rlnd-ldwg/pic-prog/hw/CP2102-UM2102_pinout.jpg

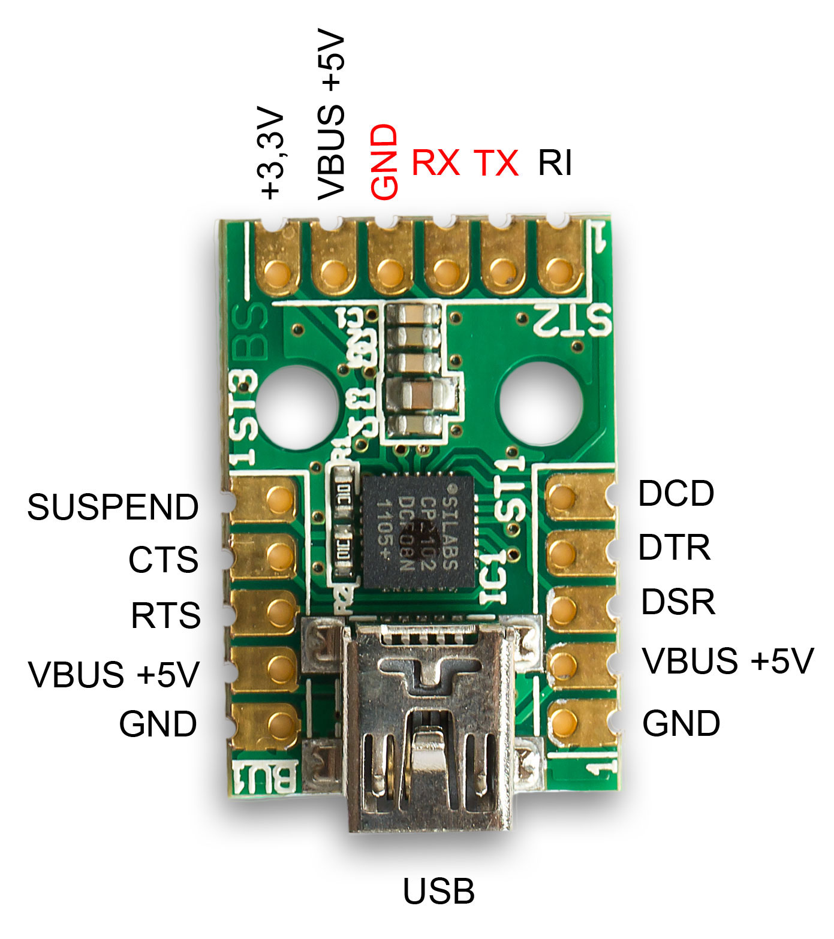
hw/CP2102-UM2102_pinout.jpg
