rlnd-ldwg/pic-prog/hw/PIC-Programmer-ICSP.png

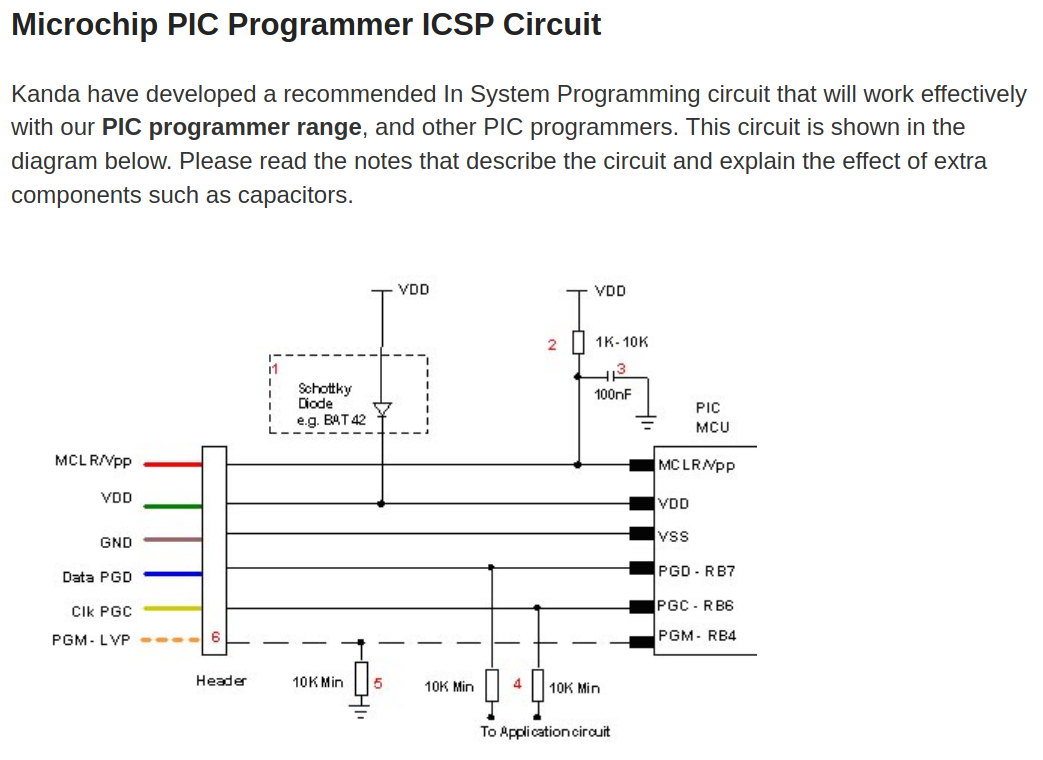
hw/PIC-Programmer-ICSP.png
