rlnd-ldwg/pic-prog/hw/PIC-Programmer_1.png

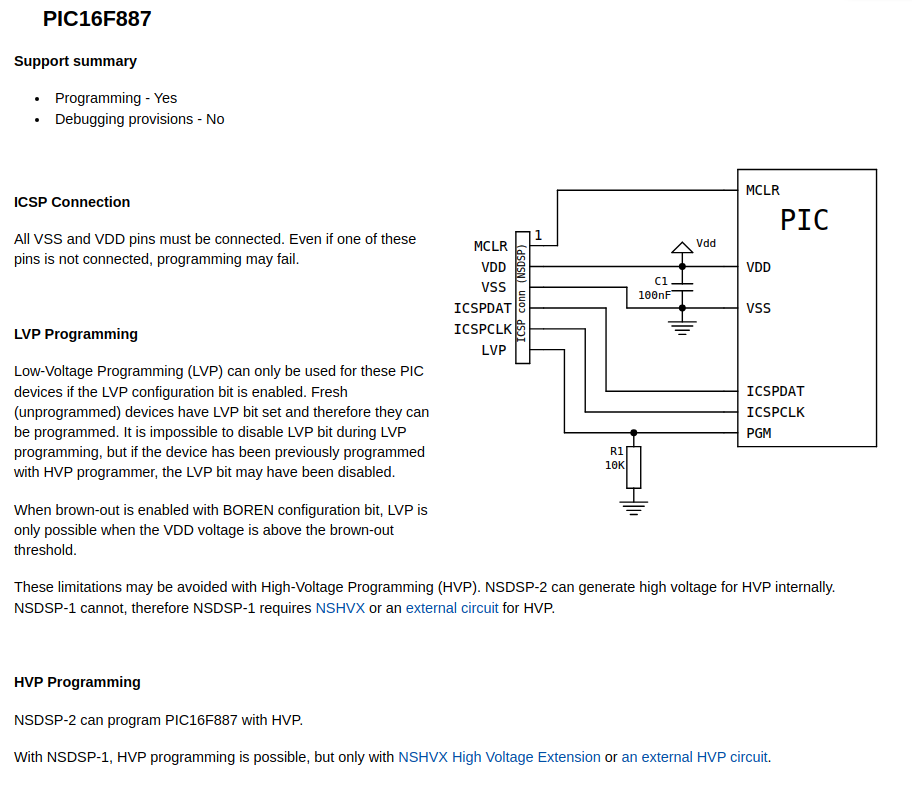
hw/PIC-Programmer_1.png
