rlnd-ldwg/pic-prog/hw/PIC-Programmer_2.png

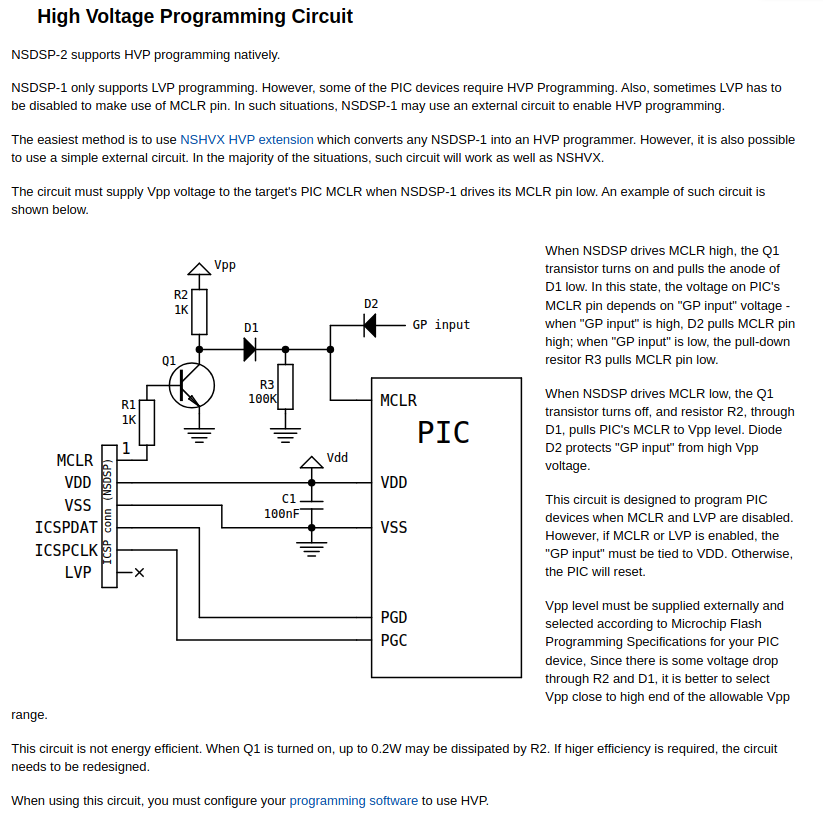
hw/PIC-Programmer_2.png
