rlnd-ldwg/pic-prog/hw/U-Verdoppler-NE555.gif

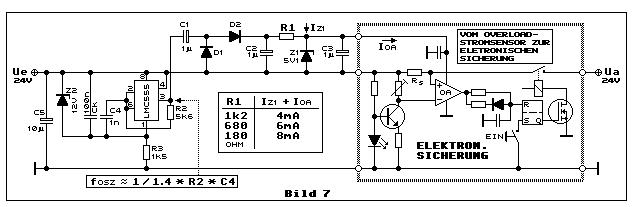
hw/U-Verdoppler-NE555.gif
