rlnd-ldwg/pic-prog/hw/USB-C_FT232.png

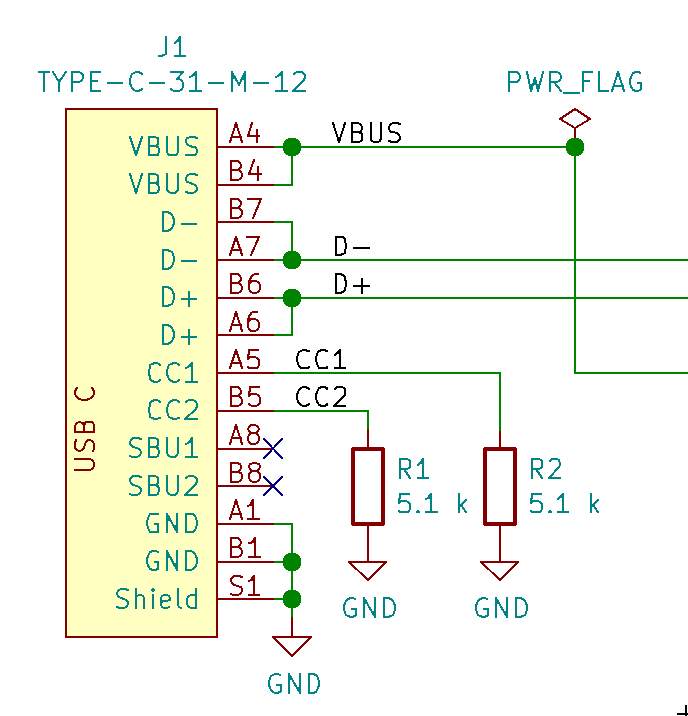
hw/USB-C_FT232.png
