rlnd-ldwg/pic-prog/hw/USB-FT232.png

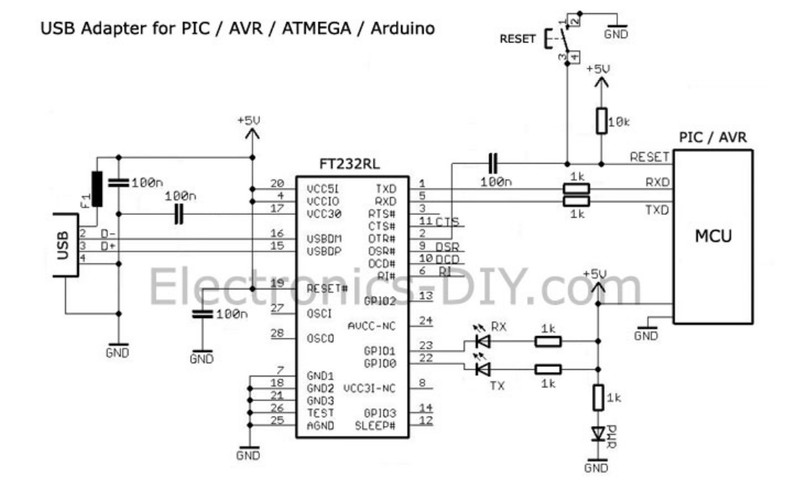
hw/USB-FT232.png
