rlnd-ldwg/pic-prog/hw/USB-Powered-FT232.png

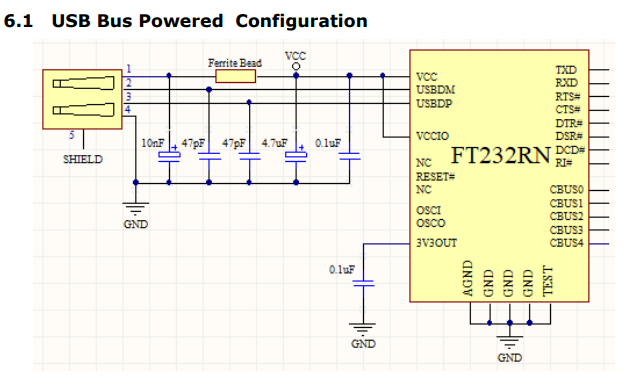
hw/USB-Powered-FT232.png
