rlnd-ldwg/pic-prog/ArdPicProg-Bauanleitung-rev02.pdf

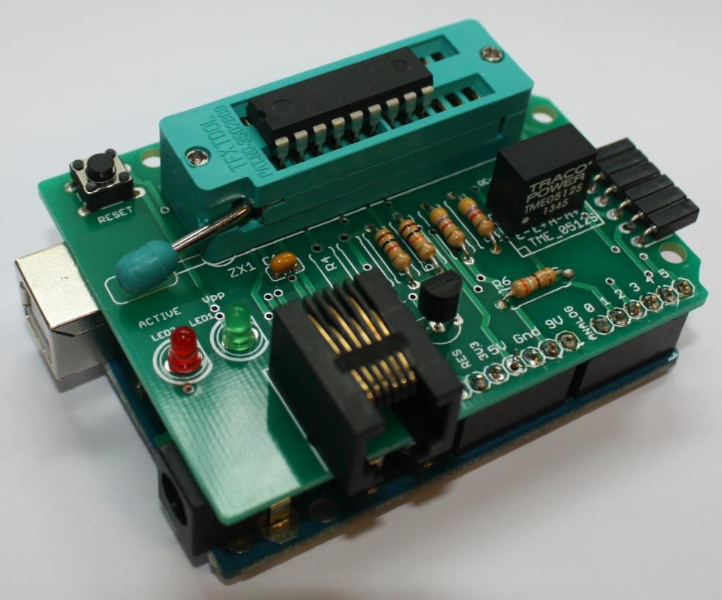
[picture p17: figure]

# ArdPicProg

# Arduino PIC Programmer

# Bauanleitung

Version 1.3
Stand 09/2018

Gregor Schlechtriem
webmaster@pikoder.de

www.pikoder.de

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

ii

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

iii

## Inhaltsverzeichnis

Allgemeine Hinweise | 5
Bausatzumfang und Hilfsmittel | 7
Aufbau | 9
Inbetriebnahme | 19
ArdPicProg Anschlussbelegung | 21
ArdPicProg Schaltung | 23

iv

5

1

# Allgemeine Hinweise

Bevor Sie mit dem Nachbau des ArdPicProg beginnen, empfiehlt es sich, dass Sie diese Bauanleitung erst einmal bis zum Ende durchlesen. Sie wissen dann, worauf es ankommt und vermeiden dadurch von vornherein Fehler, die manchmal nur noch mit viel Aufwand zu beheben sind.

Für den Nachbau des ArdPicProg werden Grundkenntnisse über elektronische Bauteile und ihre Behandlung, Löten sowie hinsichtlich des Arduino vorausgesetzt.

Führen Sie Lötungen und Verdrahtungen absolut sauber und gewissenhaft aus, verwenden Sie kein säurehaltiges Lötzinn, Lötfett o.ä. Vergewissern Sie sich, dass keine kalte Lötstelle vorhanden ist. Denn eine unsaubere Lötung oder schlechte Lötstelle, ein Wackelkontakt oder schlechter Aufbau bedeuten eine aufwändige und zeitraubende Fehlersuche und unter Umständen eine Zerstörung von Bauelementen.

Die Möglichkeit, dass nach dem Zusammenbau etwas nicht funktioniert, lässt sich durch einen gewissenhaften und sauberen Aufbau drastisch verringern. Kontrollieren Sie jeden Schritt, bevor Sie weiter gehen. Halten Sie sich an die Bauanleitung! Machen Sie den dort beschriebenen Schritt nicht anders und überspringen Sie nichts! Haken Sie jeden Schritt doppelt ab: einmal fürs Bauen, einmal fürs prüfen.

Nehmen Sie sich auf jeden Fall Zeit: Basteln ist keine Akkordarbeit und soll in erster Linie Spaß machen!

6

## Raum für eigene Notizen:

7

2

# Bausatzumfang und Hilfsmittel

Der vorliegende Bausatz enthält alle zum Aufbau eines ArdPicProg benötigten Komponenten. Bitte überprüfen Sie zunächst die Vollständigkeit anhand der folgenden Stückliste.

# Stückliste: ArdPicProgrammer

Anz. Widerstände* | Bezeichnung | √
1 | 10k, 0,25W | R1
1 | 1k, 0,25W | R2
2 | 4k7, 0,25W | R5,R7
1 | 390R, 0,25W | R6
*R3 und R4 werden nicht bestückt.

### Kondensatoren

1 | 100n | C1

### Halbleiter

1 | BC548C | Q1
1 | LED 3mm grün | LED1
1 | LED 3mm rot | LED2

### Sonstiges

2 | Pin Header 6 pol. | J3, ANALOG
2 | Pin Header 8 pol. | J1, POWER
1 | RJ-12 Buchse | J7
1 | Female Header 6 pol. gew. (2x3pol) | J8
1 | DC-DC-CONVERTER TME_0512S | TME_0512S

8

## Stückliste: ArdPicProgrammer (fortgesetzt)

Anz. | Bezeichnung | √
1 | RESET-Taster | RESET
1 | ZIF Programmiersockel 18-24pol. | ZX1
1 | Leiterplatte

Darüber hinaus werden für den Aufbau dieses Bausatzes folgende Hilfsmittel benötigt:

1. Elektroniklötkolben
2. Elektroniklötzinn
3. Seitenschneider zur Kürzung der Bauteilanschlüsse

Für die Inbetriebnahme dieses Bausatzes werden darüber hinaus noch benötigt:

1. Arduino mit Programmiersketch (Download aus dem Internet)
2. PC mit Anwendungssoftware (Download aus dem Internet)

9

3

# Aufbau

Um die Nachbausicherheit zu erhöhen, erfolgt der Aufbau in zwei Schritten:

1. Baustufe I: Montage der Bauelemente auf bzw. unter der Platine
2. Baustufe II: Inbetriebnahme und Funktionstest

Die folgenden Abschnitte beschreiben die Montage der Bauelemente auf der Platine. Zunächst werden die Bauteile auf der Platinenoberseite bestückt. Hierbei wird der Bestückungsvorgang selber durch den Bestückungsaufdruck der Leiterplatte unterstützt. Die Reihenfolge der Bestückung hängt von der Höhe der Bauteile ab – es gilt grundsätzlich, dass zunächst die flachsten Bauteile bestückt werden. Danach werden die Headerleisten, die die Verbindung zwischen dem Programmer und dem Arduino herstellen, von der Unterseite der Platine her eingesteckt und auf der Oberseite verlötet.

## Bestückung der Widerstände R1, R2 und R5 – R7

Zuerst werden die Widerstände R1, R2 und R5-R7 bestückt. Hierzu werden die Anschlussdrähte entsprechend dem Rastermaß rechtwinkelig abgebogen und in die vorgesehenen Bohrungen laut Bestückungsplan gesteckt. Bitte beachten Sie die Farbkodierung der Widerstände.

Damit die Bauteile beim Umdrehen der Platine nicht herausfallen können, biegen Sie die Anschlussdrähte ca 45° auseinander und verlöten diese dann sorgfältig mit den Leiterbahnen auf der Rückseite der Platine. Anschließend werden die überstehenden Drähte abgeschnitten.

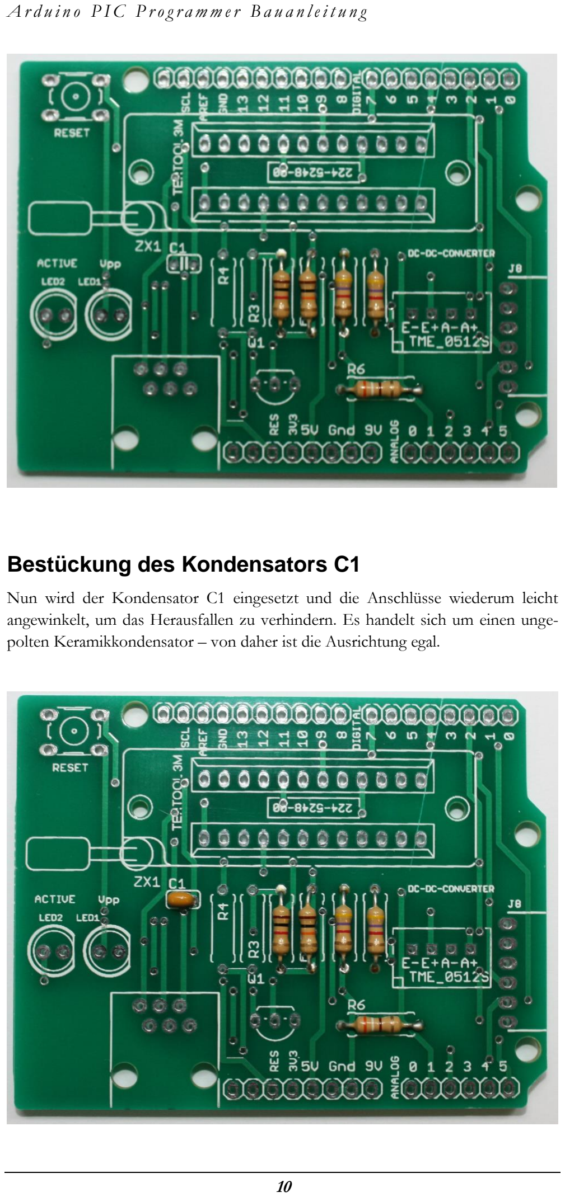
[picture p18: page 10]

10

## Bestückung des Kondensators C1

Nun wird der Kondensator C1 eingesetzt und die Anschlüsse wiederum leicht angewinkelt, um das Herausfallen zu verhindern. Es handelt sich um einen ungepolten Keramikkondensator – von daher ist die Ausrichtung egal.

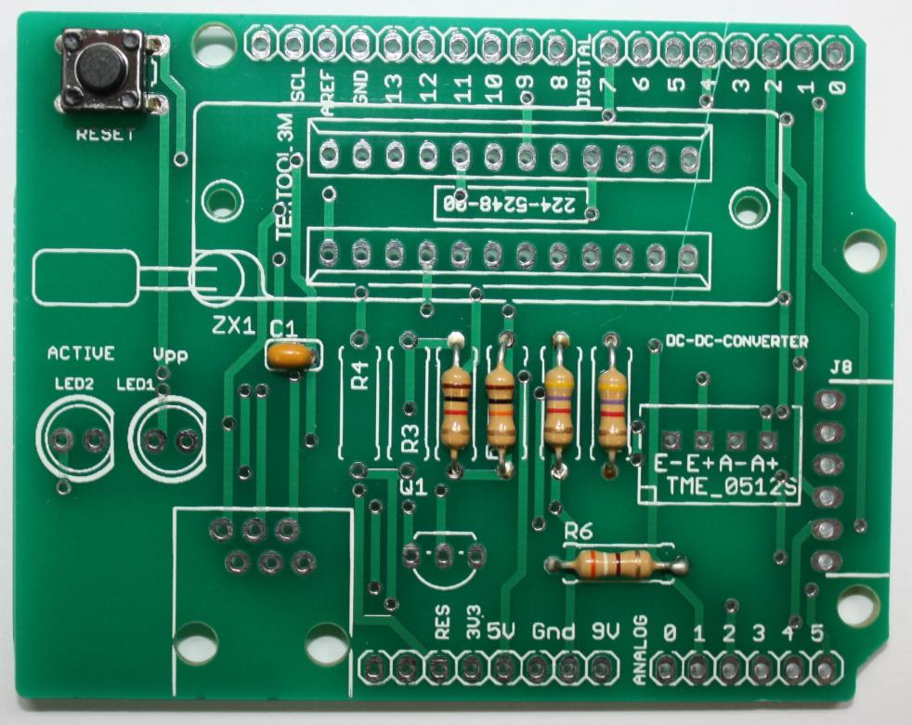
[picture p19: figure]

11

## Bestückung des Resettasters

Es folgt das Einsetzen und Verlöten des Resettasters. Die Lage der Bohrungen lässt nur eine Einbaurichtung zu – von daher ist die korrekte Ausrichtung gewährleistet.

## Bestückung der Leuchtdioden

Leuchtdioden sind gepolte Bauelemente, so dass bei der Bestückung die Einbaurichtung genau zu beachten ist. Die Gehäuse der Leuchtdioden sind an einer Seite abgeflacht – wie auch im Bestückungsaufdruck dargestellt und durch den roten Pfeil im folgenden Bild gekennzeichnet. Als zusätzliche Hilfe sind die Anschlussbeine unterschiedlich lang: der Pin an der abgeflachten Seite ist kürzer.

Stecken Sie die LEDs unter Beachtung der Polung in die entsprechende Position auf der Bestückungsseite der Leiterplatte. Die LEDs werden so eingelötet, dass das Gehäuse direkt auf der Platinenoberseite aufliegt.

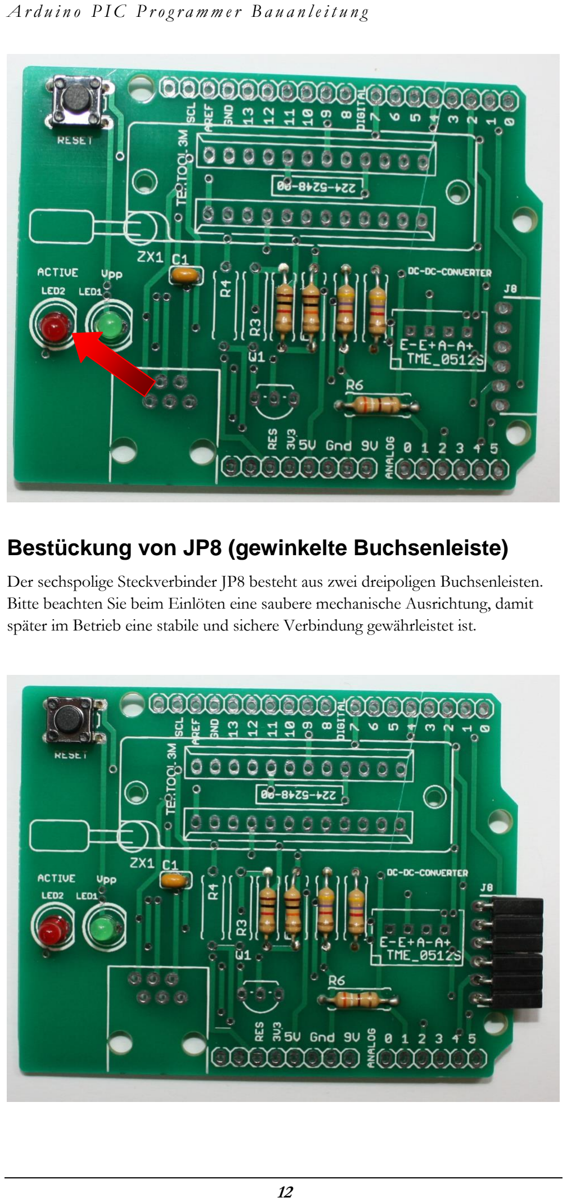
[picture p20: page 12]

12

## Bestückung von JP8 (gewinkelte Buchsenleiste)

Der sechspolige Steckverbinder JP8 besteht aus zwei dreipoligen Buchsenleisten. Bitte beachten Sie beim Einlöten eine saubere mechanische Ausrichtung, damit später im Betrieb eine stabile und sichere Verbindung gewährleistet ist.

## Bestückung des Transistors Q1

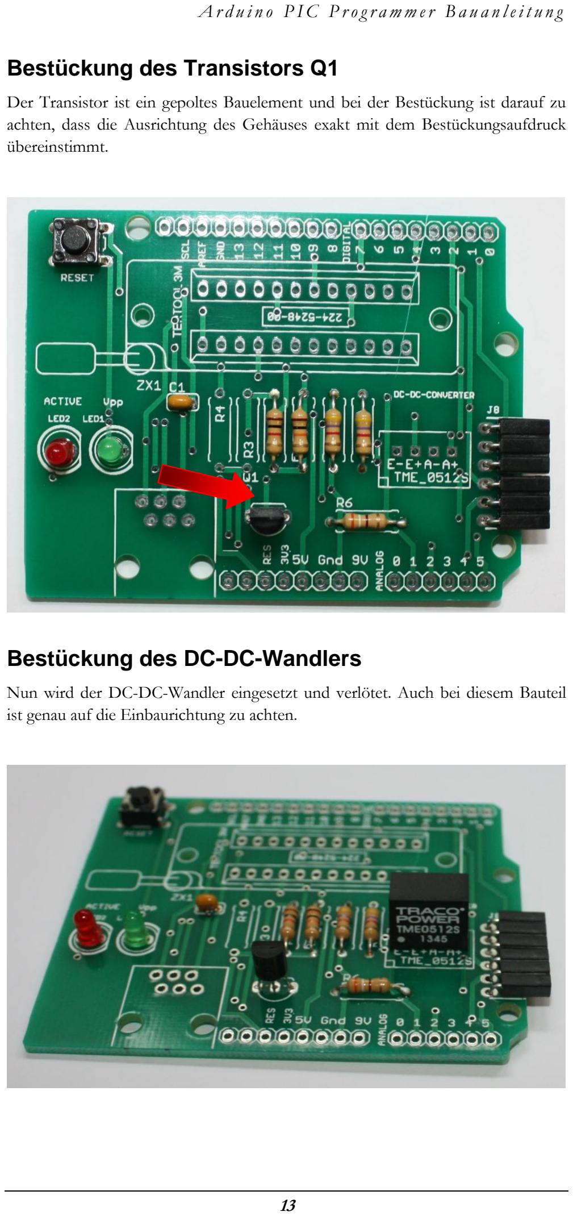
[picture p21: page 13]

13

Der Transistor ist ein gepoltes Bauelement und bei der Bestückung ist darauf zu achten, dass die Ausrichtung des Gehäuses exakt mit dem Bestückungsaufdruck übereinstimmt.

## Bestückung des DC-DC-Wandlers

Nun wird der DC-DC-Wandler eingesetzt und verlötet. Auch bei diesem Bauteil ist genau auf die Einbaurichtung zu achten.

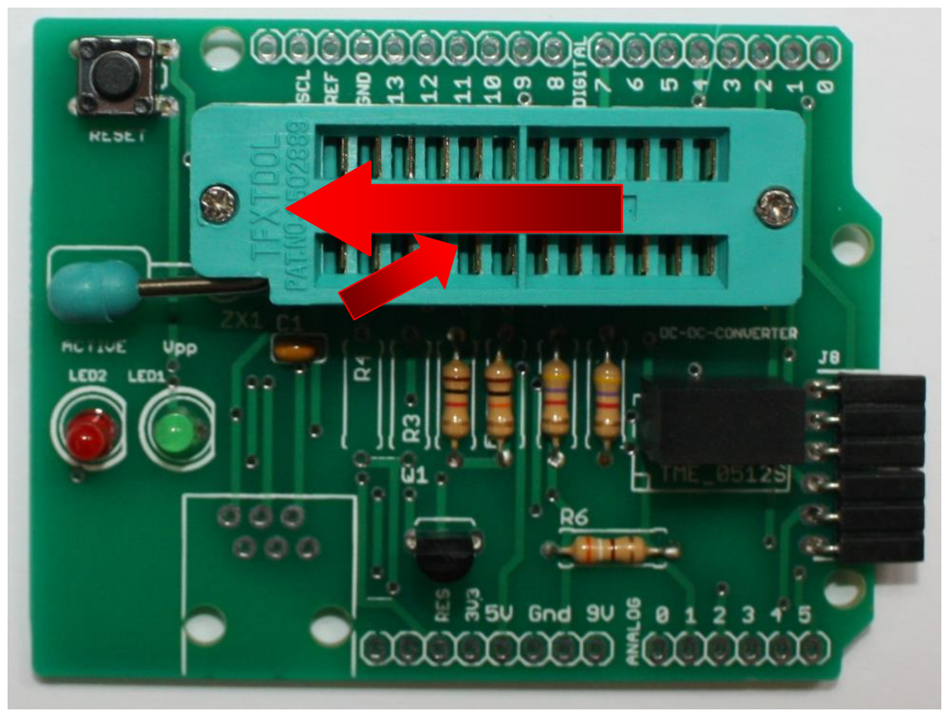
[picture p22: figure]

14

## Bestückung des Testsockels

Stecken Sie den Testsockel in die entsprechende Position auf der Bestückungsseite der Leiterplatte. Beachten Sie hierbei ebenfalls wieder die Einbaurichtung. Sollte Ihrem Bausatz ein Testsockel mit weniger als 24 Pin beiliegen, dann ist der Sockel in den vorhandenen Bohrungen linksbündig so zu positionieren, wie im nachfolgenden Bild dargestellt (die rechten Bohrungen bleiben unbenutzt)

Um zu verhindern, dass beim Herumdrehen der Platine zum Löten die Fassung wieder herausfällt, werden zwei schräg gegenüberliegende Pins der Fassung umgebogen und danach werden alle Anschlüsse verlötet.

## Bestückung der RJ12 Buchse

Als letztes Bauteil, das auf der Oberseite bestückt wird, folgt nun die RJ12 Einbaubuchse.

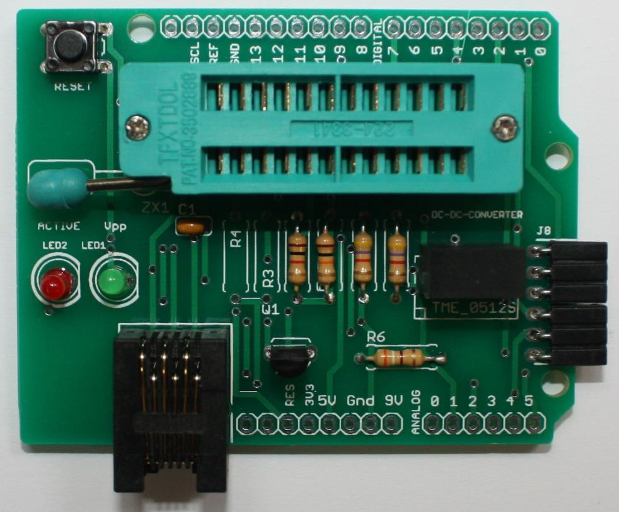
[picture p23: figure]

15

## Bestückung der Stiftleisten zur Verbindung mit dem Arduino

Nun werden die Stiftleisten bestückt. An der im Bild unteren Seite der Platine werden die beiden sechspoligen Leisten verlötet und oben die beiden achtpoligen Verbinder. Bitte brachten Sie die Position (an den Lötstellen im Bild erkennbar – die freien Bohrungen sind mit einem „X“ gekennzeichnet).

Um eine gute Ausrichtung zu erreichen, können die Steckverbinder auch in einen (spannungslosen) Arduino eingesteckt werden. Die Programmer-Leiterplatte wird dann aufgesetzt und die Steckverbinder werden dann verlötet. Der Arduino dient also als „mechanische Lehre“ und gewährleistet die korrekte Position und Ausrichtung der Pins. Hierbei ist allerdings auf zügiges Löten zu achten, um eine Beschädigung des Arduino auszuschließen.

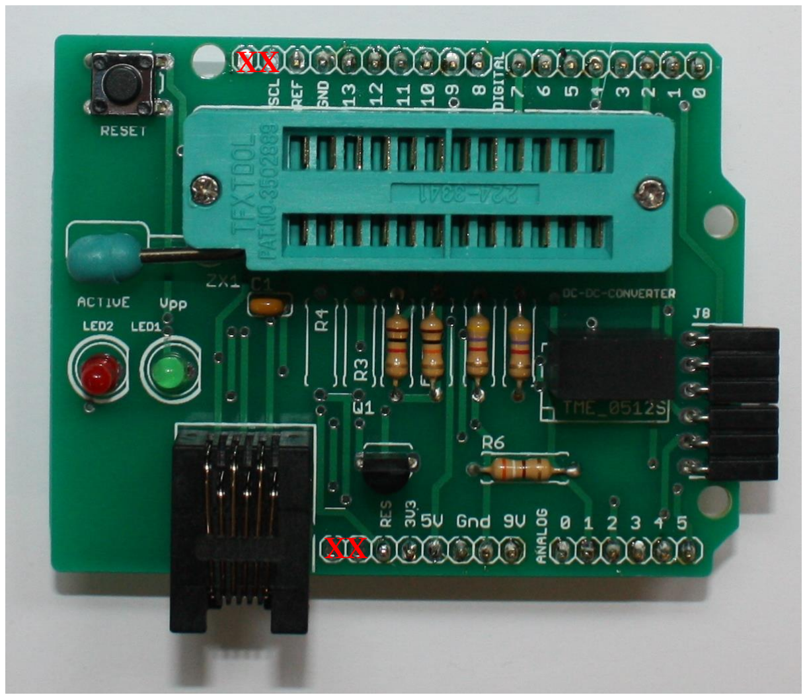
[picture p24: figure]

16

## Lötbrücke

Leider fehlt auf der Leiterplatte eine Verbindung, ohne die der Programmer nicht funktionsfähig ist.

Das nachfolgende Bild zeigt Ihnen, welche Punkte miteinander zu verbinden sind (mit rotem Pfeil gekennzeichnet). Die Verbindung selber kann, wie im grünen Rahmen dargestellt, relativ einfach durch einen „Lötklecks“ oder alternativ durch einen kurzen Draht hergestellt werden.

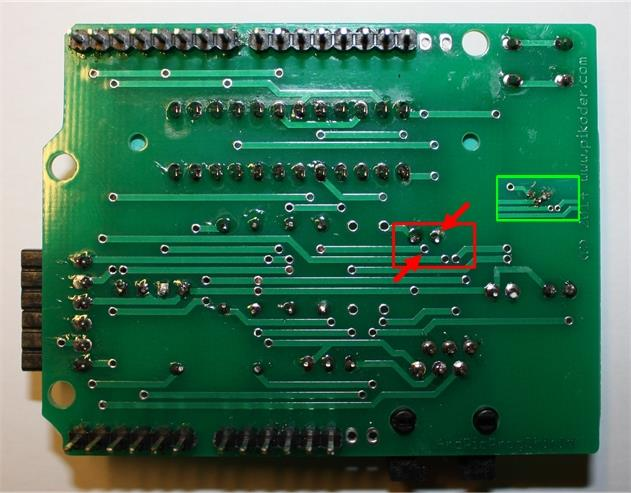
[picture p25: figure]

17

18

## Raum für eigene Notizen:

19

4

# Inbetriebnahme

Die Inbetriebnahme des Programmers ist im ArdPicProg User Guide beschrieben. Das Dokument kann auf http://www.pikoder.de/download/ArdPicProg User Guide.pdf (http://www.pikoder.de/download/ArdPicProg%20User%20Guide.pdf) herunter geladen werden.

20

## Raum für eigene Notizen:

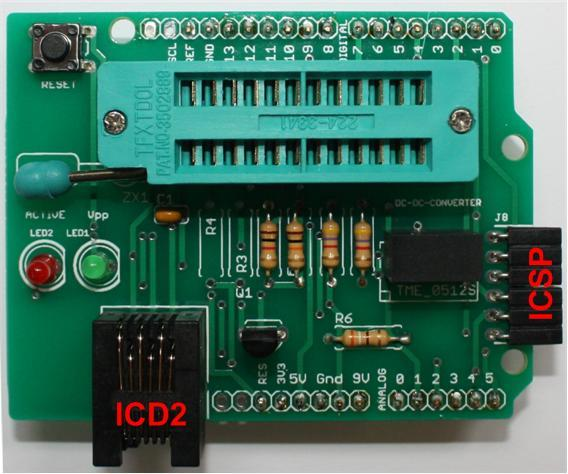
[picture p26: figure]

21

A

# ArdPicProg Anschlussbelegung

22

## Raum für eigene Notizen:

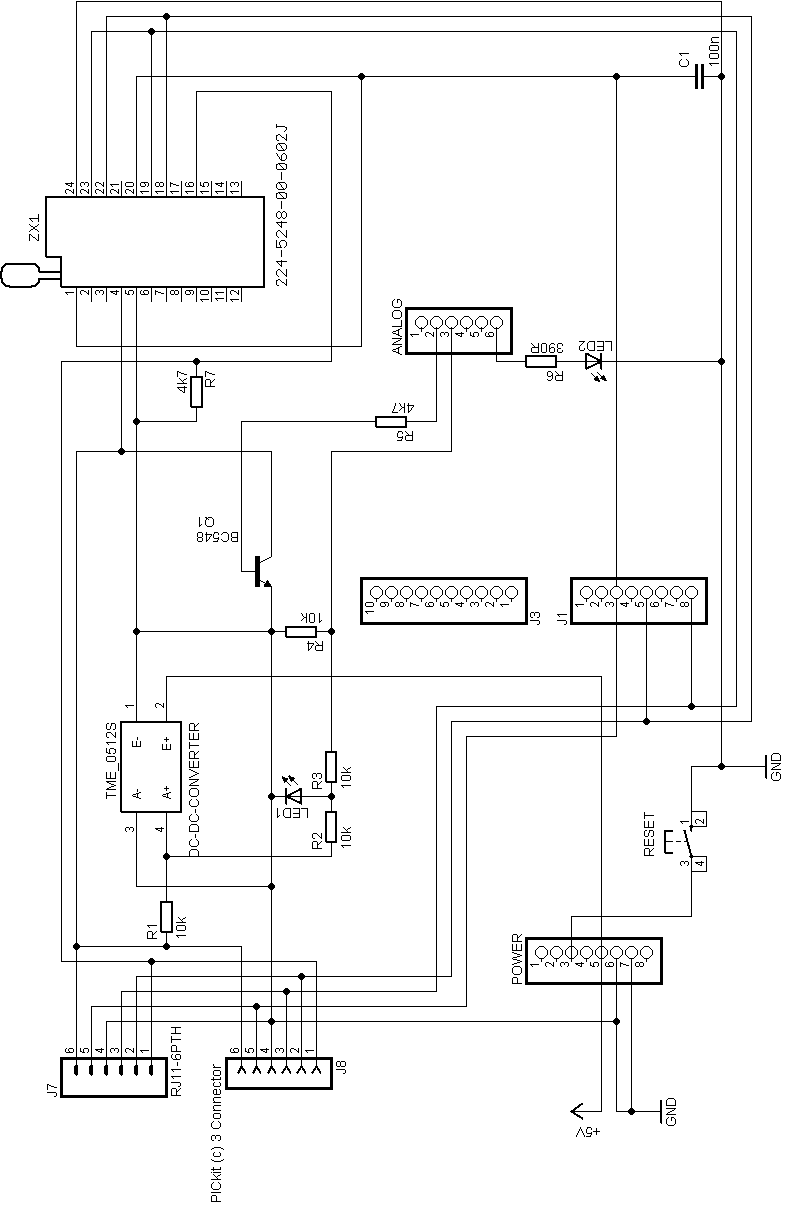
[picture p27: figure]

23

B

# ArdPicProg Schaltung
