rlnd-ldwg/pic-prog/hw/Prints.odt

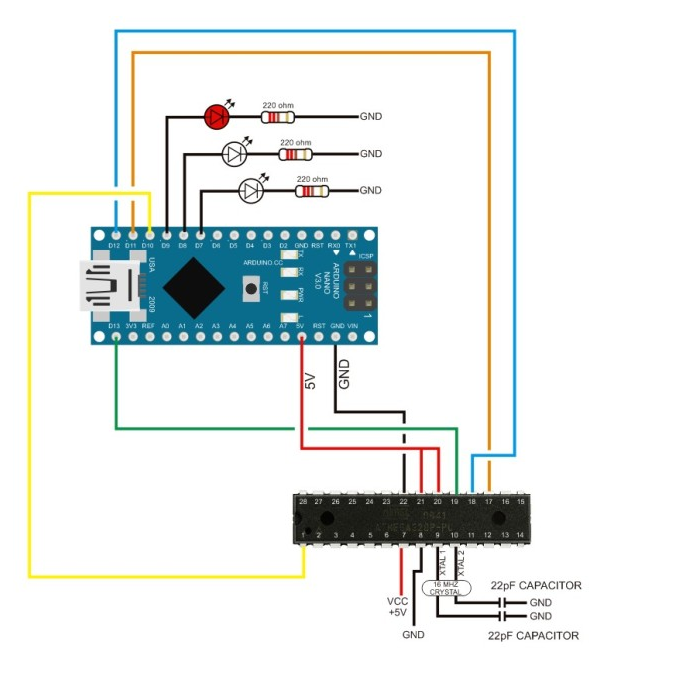
[picture p28: figure]
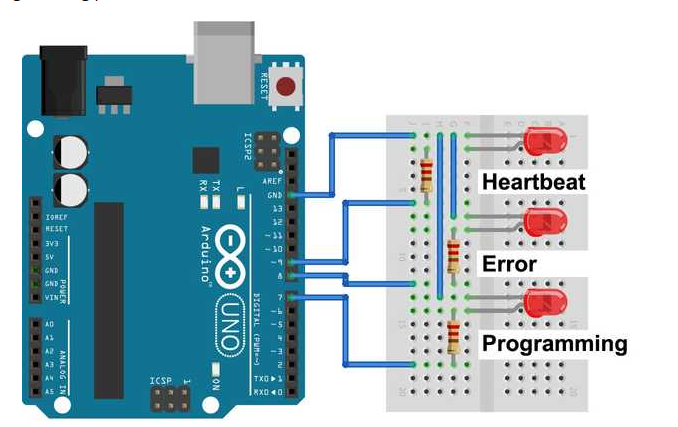
[picture p29: figure]
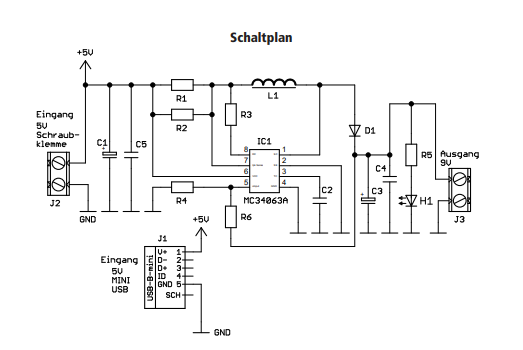
[picture p30: figure]

https://www.mikrocontroller.net/articles/MC34063

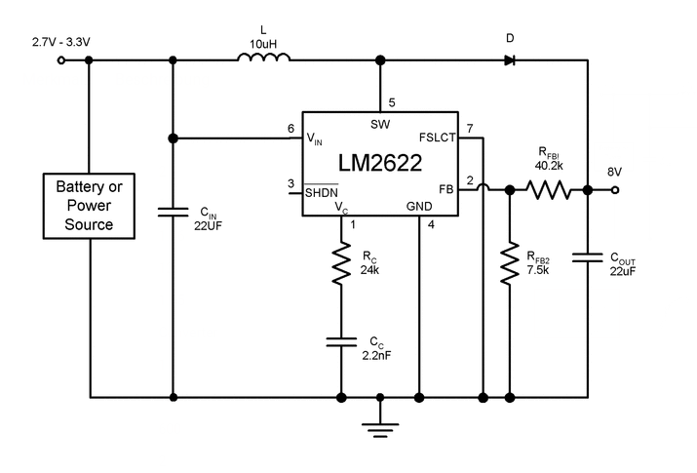
[picture p31: figure]

https://www.ti.com/product/de-de/LM2622

Original

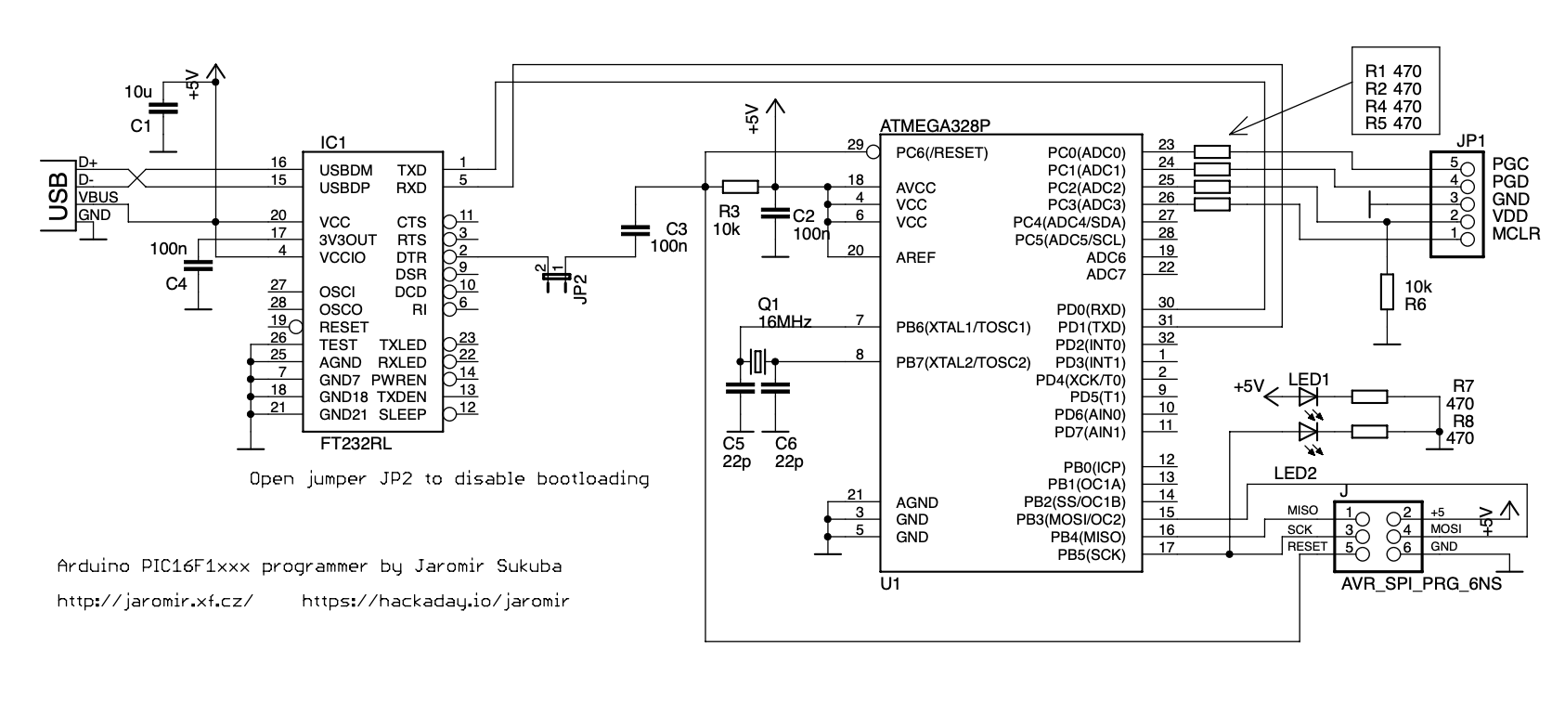
[picture p32: figure]

HVP

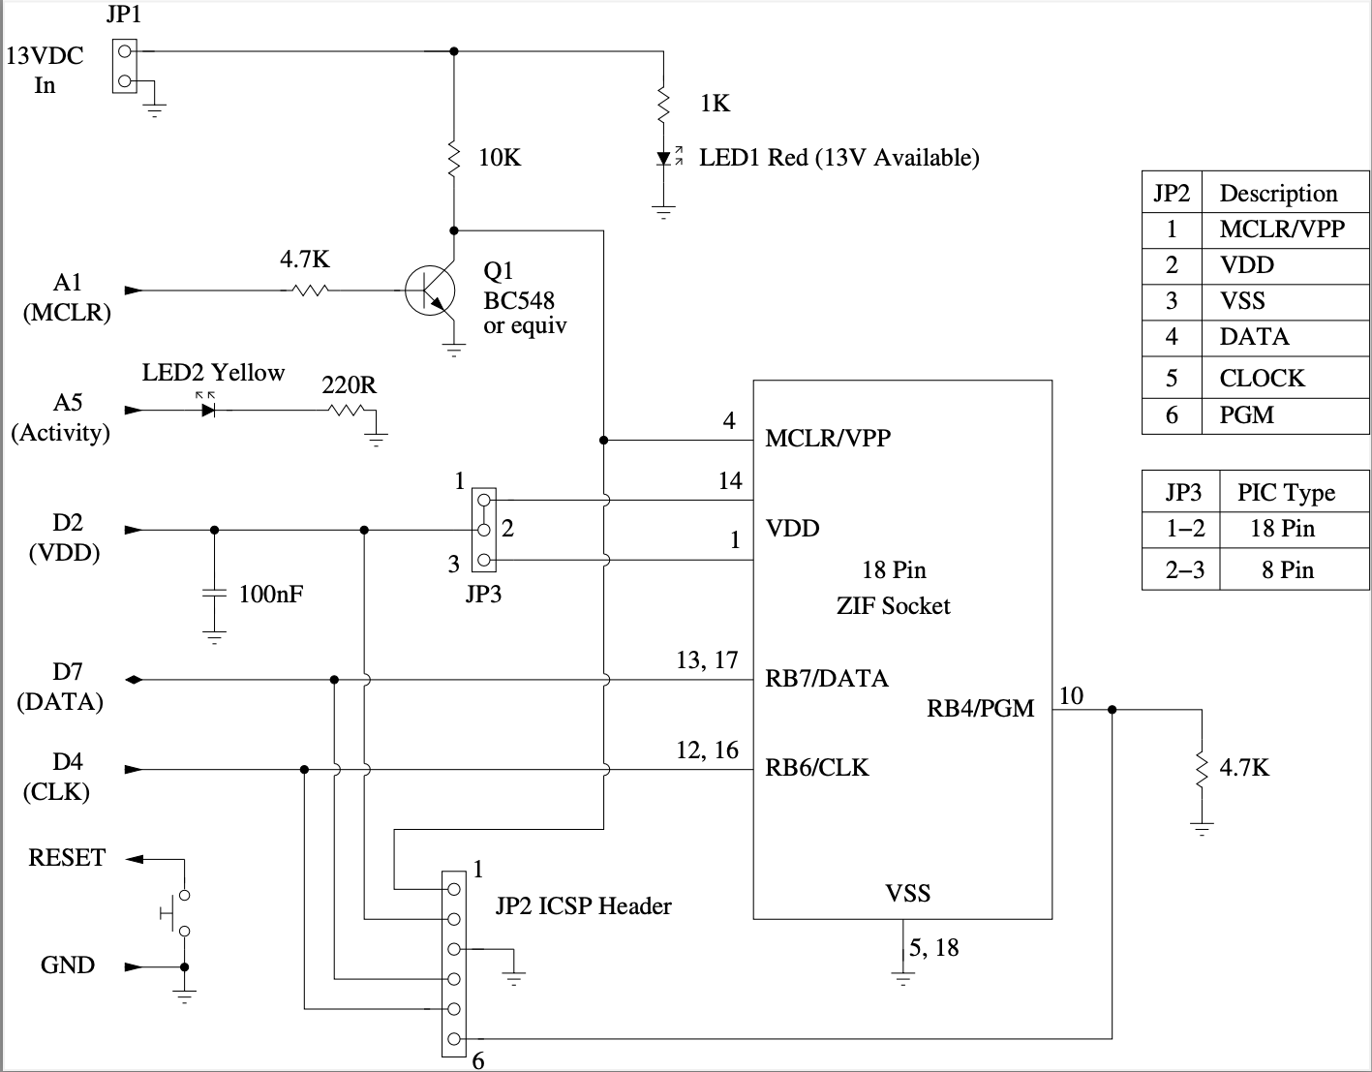
[picture p33: figure]
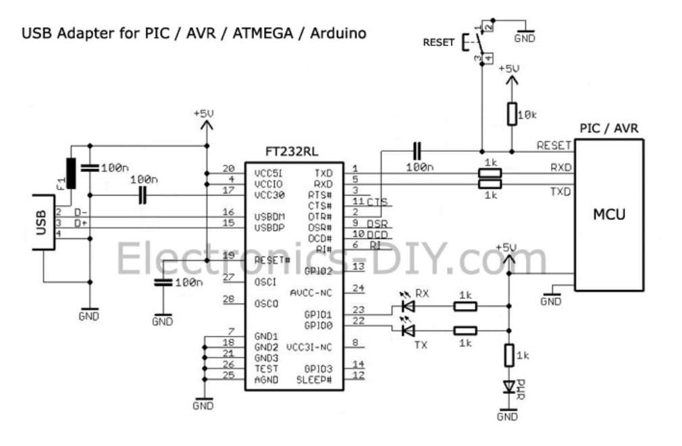
[picture p34: figure]
