rlnd-ldwg/pic-prog/hw/KiCAD/pic-prog.sch.pdf

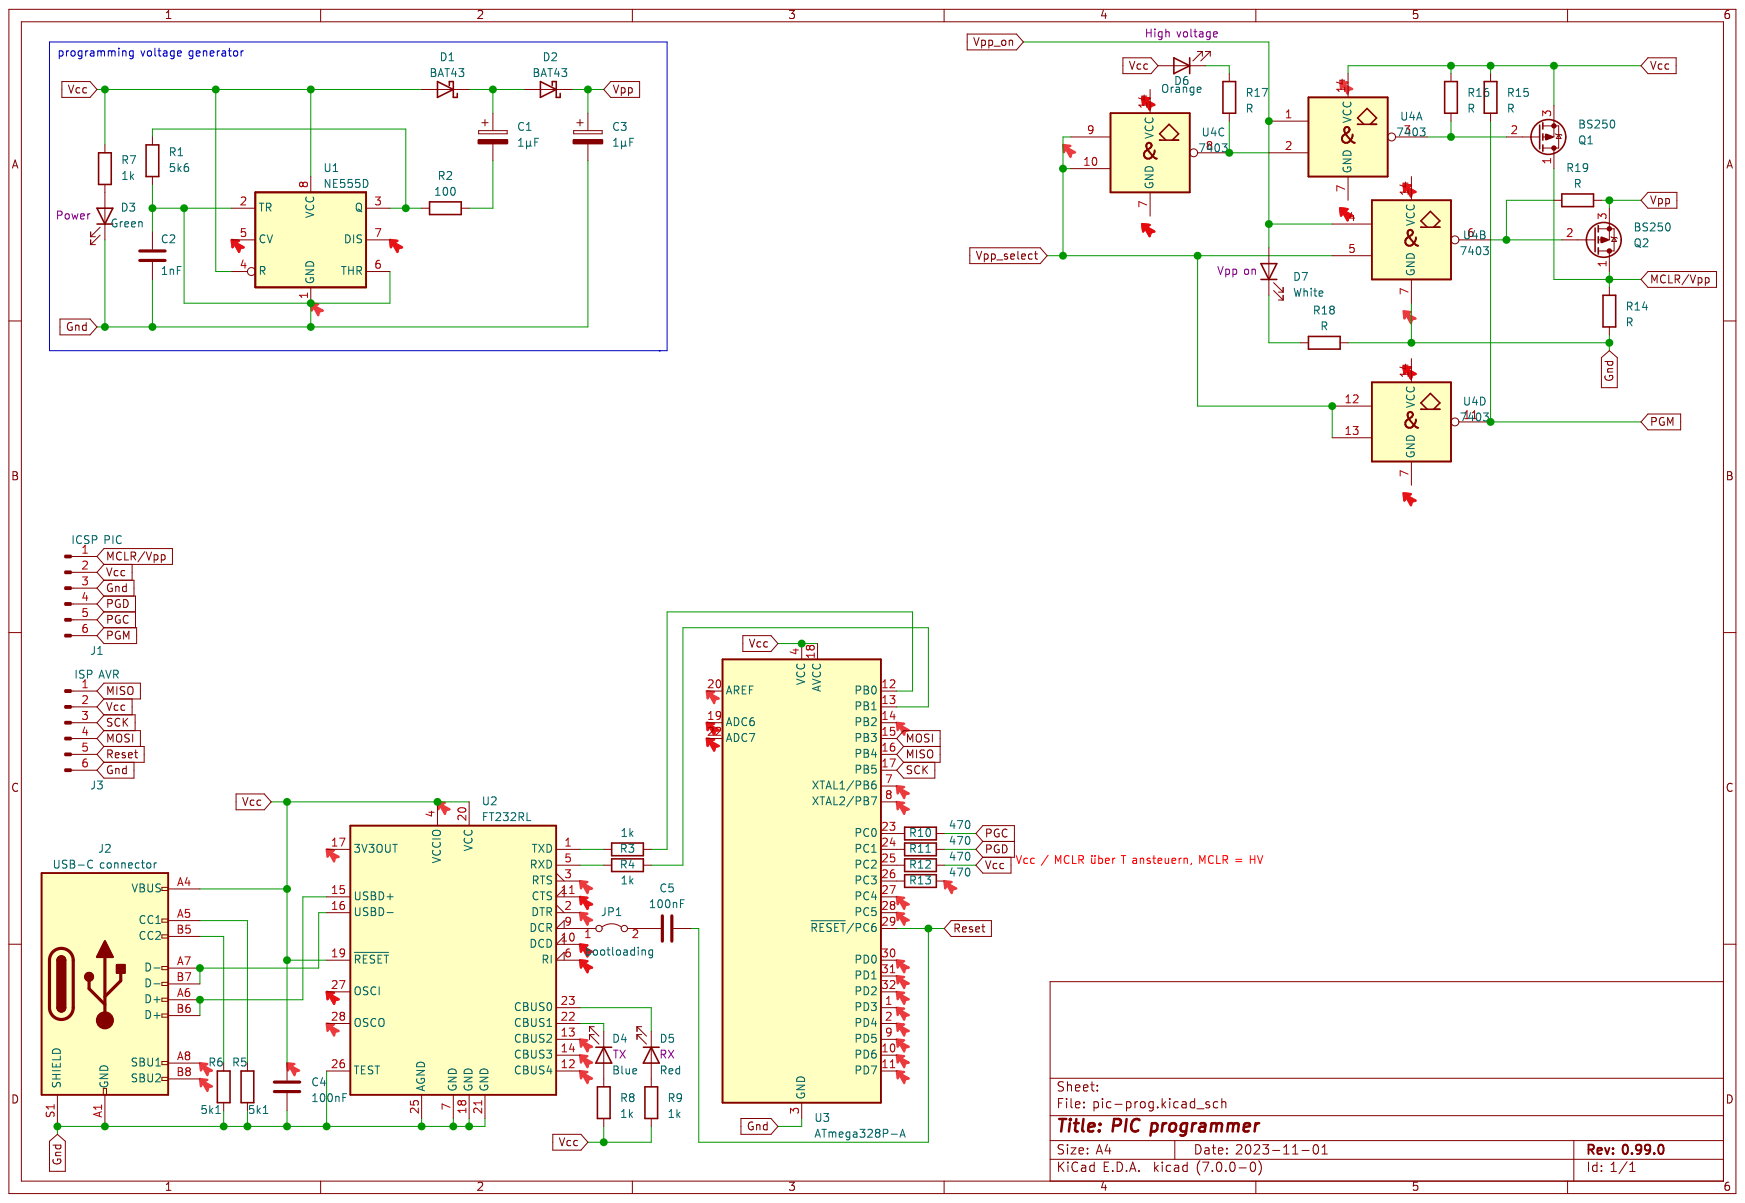
[picture p35: page 1]
