rlnd-ldwg/pic-prog/(list of files, drawings)

Other design files:
hw/KiCAD/pic-prog.dsn
