rlnd-ldwg/pic-prog/hw/KiCAD/pic-prog.kicad_pcb

## KiCad design hw/KiCAD/pic-prog.kicad_pcb (2023-11-05)

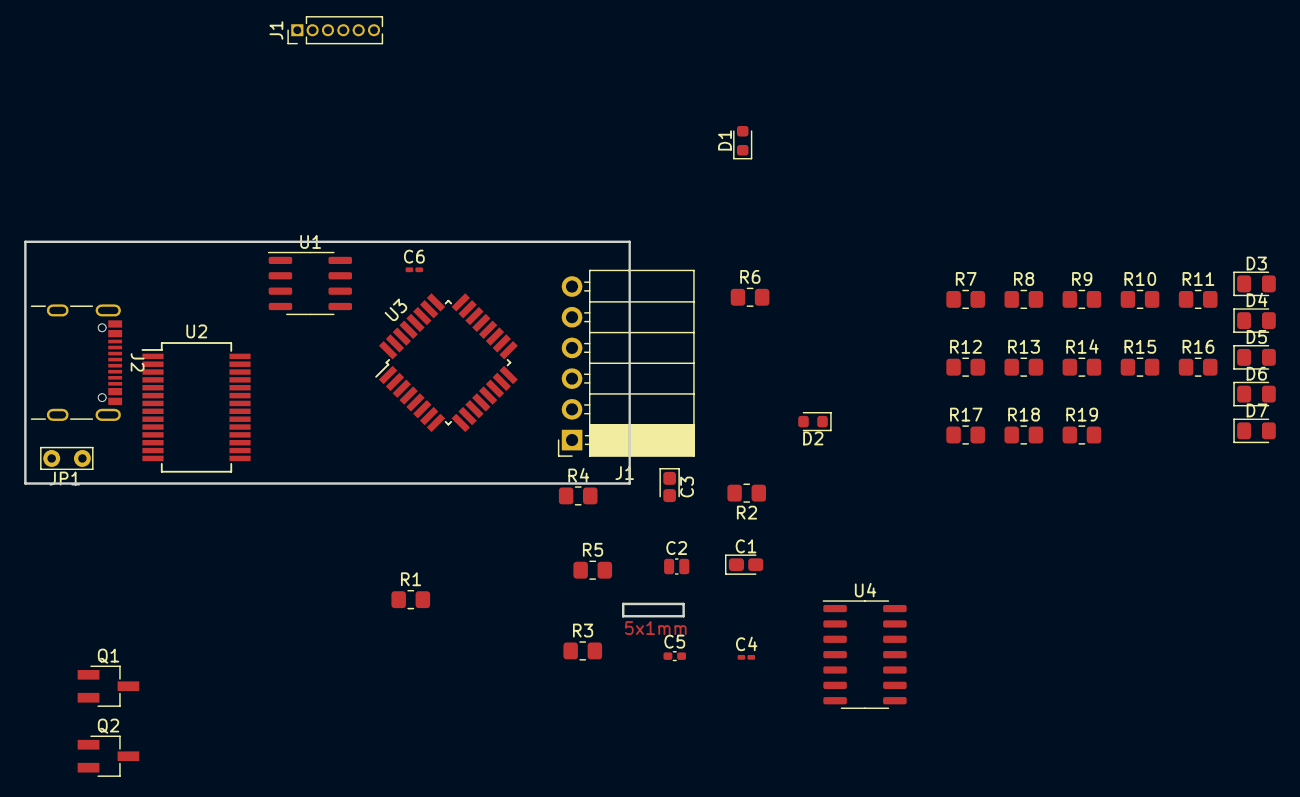
[picture p36: board pic-prog.kicad_pcb from above]

Board: 2 copper layers, 42 parts (0 on the bottom side), 38 nets, no tracks yet.

Parts:
C1: 1µF; CP_EIA-1608-10_AVX-L_Pad1.25x1.05mm_HandSolder
C2: 1nF; C_0504_1310Metric_Pad0.83x1.28mm_HandSolder
C3: 1µF; CP_EIA-1608-08_AVX-J
C4: 100nF; C_0201_0603Metric_Pad0.64x0.40mm_HandSolder
C5: 100nF; C_0402_1005Metric_Pad0.74x0.62mm_HandSolder
C6: C; C_0201_0603Metric_Pad0.64x0.40mm_HandSolder
D1, D2: BAT43; D_0603_1608Metric
D3: Green; D_0805_2012Metric_Pad1.15x1.40mm_HandSolder
D4: Blue; D_0805_2012Metric_Pad1.15x1.40mm_HandSolder
D5: Red; D_0805_2012Metric_Pad1.15x1.40mm_HandSolder
D6: Orange; D_0805_2012Metric_Pad1.15x1.40mm_HandSolder
D7: White; D_0805_2012Metric_Pad1.15x1.40mm_HandSolder
J1: ICSP PIC; PinSocket_1x06_P2.54mm_Horizontal
J1#2: ISP AVR; PinHeader_1x06_P1.27mm_Vertical
J2: USB-C connector; USB_C_Receptacle_GCT_USB4105-xx-A_16P_TopMnt_Horizontal
JP1: bootloading; TestPoint_Bridge_Pitch2.54mm_Drill0.7mm
Q1, Q2: BS250; SC-59_Handsoldering
R1: 5k6; R_0805_2012Metric_Pad1.20x1.40mm_HandSolder
R2: 100; R_0805_2012Metric_Pad1.20x1.40mm_HandSolder
R3, R4, R7, R8, R9: 1k; R_0805_2012Metric_Pad1.20x1.40mm_HandSolder
R5, R6: 5k1; R_0805_2012Metric_Pad1.20x1.40mm_HandSolder
R10, R11, R12, R13: 470; R_0805_2012Metric_Pad1.20x1.40mm_HandSolder
R14, R15, R16, R17, R18, R19: R; R_0805_2012Metric_Pad1.20x1.40mm_HandSolder
U1: NE555D; SOIC-8_3.9x4.9mm_P1.27mm
U2: FT232RL; SSOP-28_5.3x10.2mm_P0.65mm
U3: ATmega328P-A; TQFP-32_7x7mm_P0.8mm
U4: 7403; SOIC-14_3.9x8.7mm_P1.27mm

Connections:
Gnd: C2.1, C2.2, C3.2, C4.2, D3.1 (K), J1.3, J1#2.6, J2.A1 (GND), J2.A12 (GND), J2.B1 (GND), J2.B12 (GND), J2.S1 (SHIELD), R1.1, R5.2, R6.2, R14.2, R18.2, U1.1 (GND), U1.2 (TR), U1.6 (THR), U2.7 (GND), U2.18 (GND), U2.21 (GND), U2.25 (AGND), U2.26 (TEST), U3.3 (GND), U3.5 (GND), U3.21 (GND), U4.7 (GND)
MCLR/Vpp: J1.1, Q1.1 (D), Q2.1 (D), R14.1
MISO: J1#2.1, U3.16 (PB4)
MOSI: J1#2.4, U3.15 (PB3)
unnamed: C1.2, R2.1
unnamed: C1.1, D1.1 (K), D2.2 (A)
unnamed: D3.2 (A), R7.2
unnamed: D4.2 (A), R8.1
unnamed: D4.1 (K), U2.22 (CBUS1)
unnamed: D5.2 (A), R9.1
unnamed: D5.1 (K), U2.23 (CBUS0)
unnamed: D6.1 (K), R17.1
unnamed: D7.1 (K), R18.1
unnamed: J2.A5 (CC1), R5.1
unnamed: J2.B5 (CC2), R6.1
unnamed: JP1.1 (A), U2.9 (DCR)
unnamed: Q1.2 (G), R16.2, U4.3
unnamed: R17.2, U4.2, U4.8
unnamed: R1.2, R2.2, U1.3 (Q)
unnamed: R4.1, U2.5 (RXD)
unnamed: R3.1, U2.1 (TXD)
unnamed: J2.A6 (D+), J2.B6 (D+), U2.15 (USBD+)
unnamed: J2.A7 (D-), J2.B7 (D-), U2.16 (USBD-)
unnamed: R3.2, U3.12 (PB0)
unnamed: R4.2, U3.13 (PB1)
unnamed: R10.1, U3.23 (PC0)
unnamed: R11.1, U3.24 (PC1)
unnamed: R12.1, U3.25 (PC2)
unnamed: R13.1, U3.26 (PC3)
PGC: J1.5, R10.2
PGD: J1.4, R11.2
PGM: J1.6, Q2.2 (G), R15.2, R19.2, U4.6, U4.11
Reset: C5.2, J1#2.5, U3.29 (~RESET/PC6)
SCK: J1#2.3, U3.17 (PB5)
Vcc: C4.1, D1.2 (A), D6.2 (A), J1.2, J1#2.2, J2.A4 (VBUS), J2.A9 (VBUS), J2.B4 (VBUS), J2.B9 (VBUS), Q1.3 (S), R7.1, R8.2, R9.2, R12.2, R15.1, R16.1, R19.1, U1.4 (R), U1.8 (VCC), U2.4 (VCCIO), U2.19 (~RESET), U2.20 (VCC), U3.4 (VCC), U3.6 (VCC), U3.18 (AVCC), U4.14 (VCC)
Vpp: C3.1, D2.1 (K), Q2.3 (S)
Vpp_on: D7.2 (A), U4.1, U4.4
Vpp_select: U4.5, U4.9, U4.10, U4.12, U4.13
