rlnd-ldwg/pic-prog/(commit log)

2023-03-12 Add PIC 18F47Q43 and 18F47Q84 functions
    These changes are based on satoshiokue's work.
    See commit e233817f2a24 on the main branch on the repository
    https://github.com/satoshiokue/Arduino-PIC-Programmer.
2023-03-12 Add PIC 18F47Q43 and 18F47Q84
    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
2023-03-12 Increase isp writing delay for PIC 18F47Qxx
    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
2023-03-12 Add 18F47Q43 and 18F47Q84 to the supported device list
2023-03-25 Add Arduino Leonardo board support
2023-03-25 Add 5 us delay in p18*_write_page() for Arduino Leonardo
2023-06-24 support high voltage programming
2023-10-25 Command file, include path for pio
    [info.ods]
2023-10-26 introduction of constants for commands / changed "if" statements to "switch"
2023-11-05 new hardware interface - not yet tested
    [info.ods, pic-prog.csv, pic-prog.dsn, pic-prog.kicad_pcb, pic-prog.kicad_sch]
2023-11-05 changed directory name
    [pic-prog.csv, pic-prog.dsn, pic-prog.kicad_pcb, pic-prog.kicad_sch]
